DasBasti/DuetX/README.md

# DuetX
Duet electronics extension Board with up to four more stepper driver
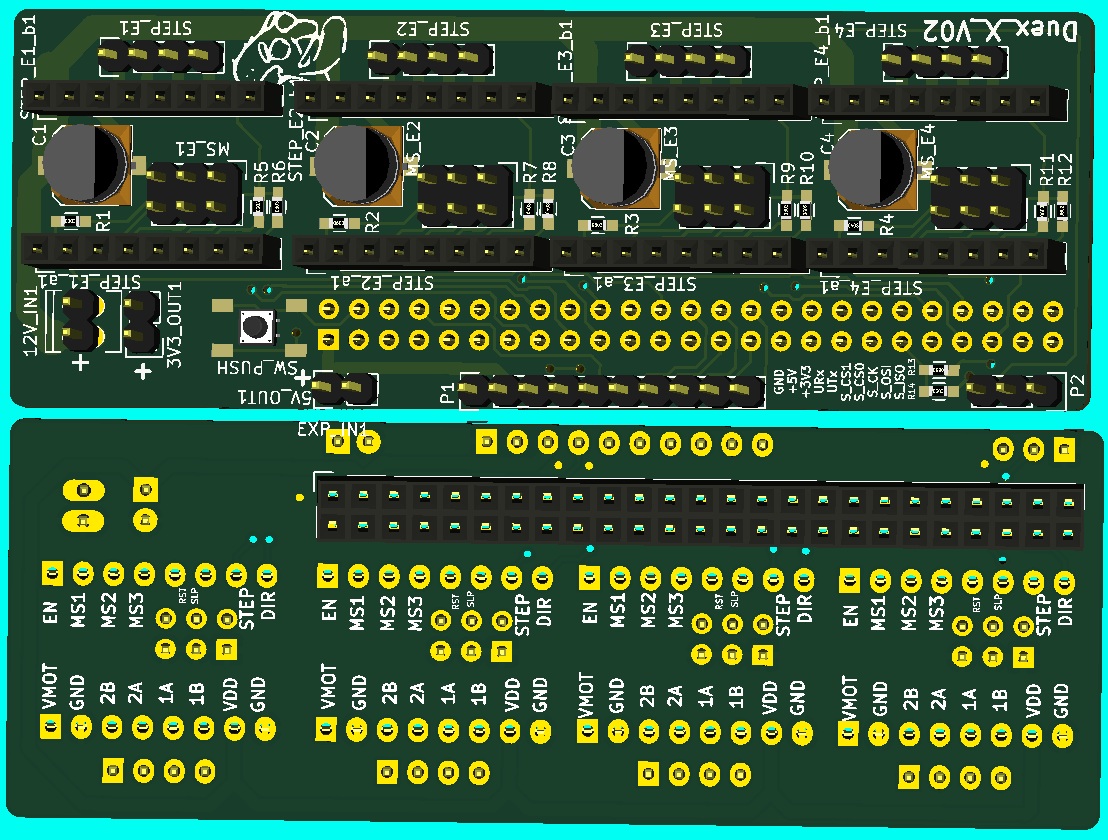
[picture p1: 3D.jpg]
3D rendering


#License
This hardware is open-source under the CERN Open Hardware License (OSH) V1.2
