DasBasti/DuetX/BOM_RS.xlsx

ref | value | footprint | RS
EXP_IN1 | CONN_02X25 | Pin_Headers:Pin_Header_Straight_2x25 | 628-8464
STEP_E1_a1 | CONN_01X08 | Pin_Headers:Pin_Header_Straight_1x08 | 827-734
STEP_E1_b1 | CONN_01X08 | Pin_Headers:Pin_Header_Straight_1x08 | 827-734
MS_E1 | CONN_02X03 | Pin_Headers:Pin_Header_Straight_2x03 | 827-7781
STEP_E1 | CONN_01X04 | Pin_Headers:Pin_Header_Straight_1x04 | 681-2988
12V_IN1 | CONN_01X02 | sirona:mkds_1,5-2 | 425-8720
5V_OUT1 | CONN_01X02 | Pin_Headers:Pin_Header_Straight_1x02 | n_best
R5 | 10K | Resistors_SMD:R_0603_HandSoldering | 678-9667
R6 | 10K | Resistors_SMD:R_0603_HandSoldering | 678-9667
C1 | CP2 | Capacitors_SMD:c_elec_6.3x5.7 | 844-0926
STEP_E2_a1 | CONN_01X08 | Pin_Headers:Pin_Header_Straight_1x08 | 827-734
STEP_E2_b1 | CONN_01X08 | Pin_Headers:Pin_Header_Straight_1x08 | 827-734
MS_E2 | CONN_02X03 | Pin_Headers:Pin_Header_Straight_2x03 | 827-7781
STEP_E2 | CONN_01X04 | Pin_Headers:Pin_Header_Straight_1x04 | 681-2988
R7 | 10K | Resistors_SMD:R_0603_HandSoldering | 678-9667
R8 | 10K | Resistors_SMD:R_0603_HandSoldering | 678-9667
C2 | CP2 | Capacitors_SMD:c_elec_6.3x5.7 | 844-0926
STEP_E3_a1 | CONN_01X08 | Pin_Headers:Pin_Header_Straight_1x08 | 827-734
STEP_E3_b1 | CONN_01X08 | Pin_Headers:Pin_Header_Straight_1x08 | 827-734
MS_E3 | CONN_02X03 | Pin_Headers:Pin_Header_Straight_2x03 | 827-7781
STEP_E3 | CONN_01X04 | Pin_Headers:Pin_Header_Straight_1x04 | 681-2988
R9 | 10K | Resistors_SMD:R_0603_HandSoldering | 678-9667
R10 | 10K | Resistors_SMD:R_0603_HandSoldering | 678-9667
C3 | CP2 | Capacitors_SMD:c_elec_6.3x5.7 | 844-0926
STEP_E4_a1 | CONN_01X08 | Pin_Headers:Pin_Header_Straight_1x08 | 827-734
STEP_E4_b1 | CONN_01X08 | Pin_Headers:Pin_Header_Straight_1x08 | 827-734
MS_E4 | CONN_02X03 | Pin_Headers:Pin_Header_Straight_2x03 | 827-7781
STEP_E4 | CONN_01X04 | Pin_Headers:Pin_Header_Straight_1x04 | 681-2988
R11 | 10K | Resistors_SMD:R_0603_HandSoldering | 678-9667
R12 | 10K | Resistors_SMD:R_0603_HandSoldering | 678-9667
C4 | CP2 | Capacitors_SMD:c_elec_6.3x5.7 | 844-0926
3V3_OUT1 | CONN_01X02 | Pin_Headers:Pin_Header_Straight_1x02 | n_best
R4 | 10K | Resistors_SMD:R_0603_HandSoldering | 678-9667
R3 | 10K | Resistors_SMD:R_0603_HandSoldering | 678-9667
R2 | 10K | Resistors_SMD:R_0603_HandSoldering | 678-9667
R1 | 10K | Resistors_SMD:R_0603_HandSoldering | 678-9667
SW1 | SW_PUSH | sirona:TACT_switch
P1 | CONN_01X10 | Pin_Headers:Pin_Header_Straight_1x10 | n_best
P2 | CONN_01X03 | Pin_Headers:Pin_Header_Straight_1x03 | n_best
R13 | 2K7 | Resistors_SMD:R_0603_HandSoldering | n_best
R14 | 1K | Resistors_SMD:R_0603_HandSoldering | n_best
R18 | 10K | Resistors_SMD:R_0603_HandSoldering | 678-9667
R17 | 10K | Resistors_SMD:R_0603_HandSoldering | 678-9667
R16 | 10K | Resistors_SMD:R_0603_HandSoldering | 678-9667
R15 | 10K | Resistors_SMD:R_0603_HandSoldering | 678-9667
 |  |  | 462.30 €
 |  |  | 15.41 €
 |  | Driver 4 Stk 5€
 |  | PCB 42€
