DasBasti/DuetX/DUETX_X.pdf

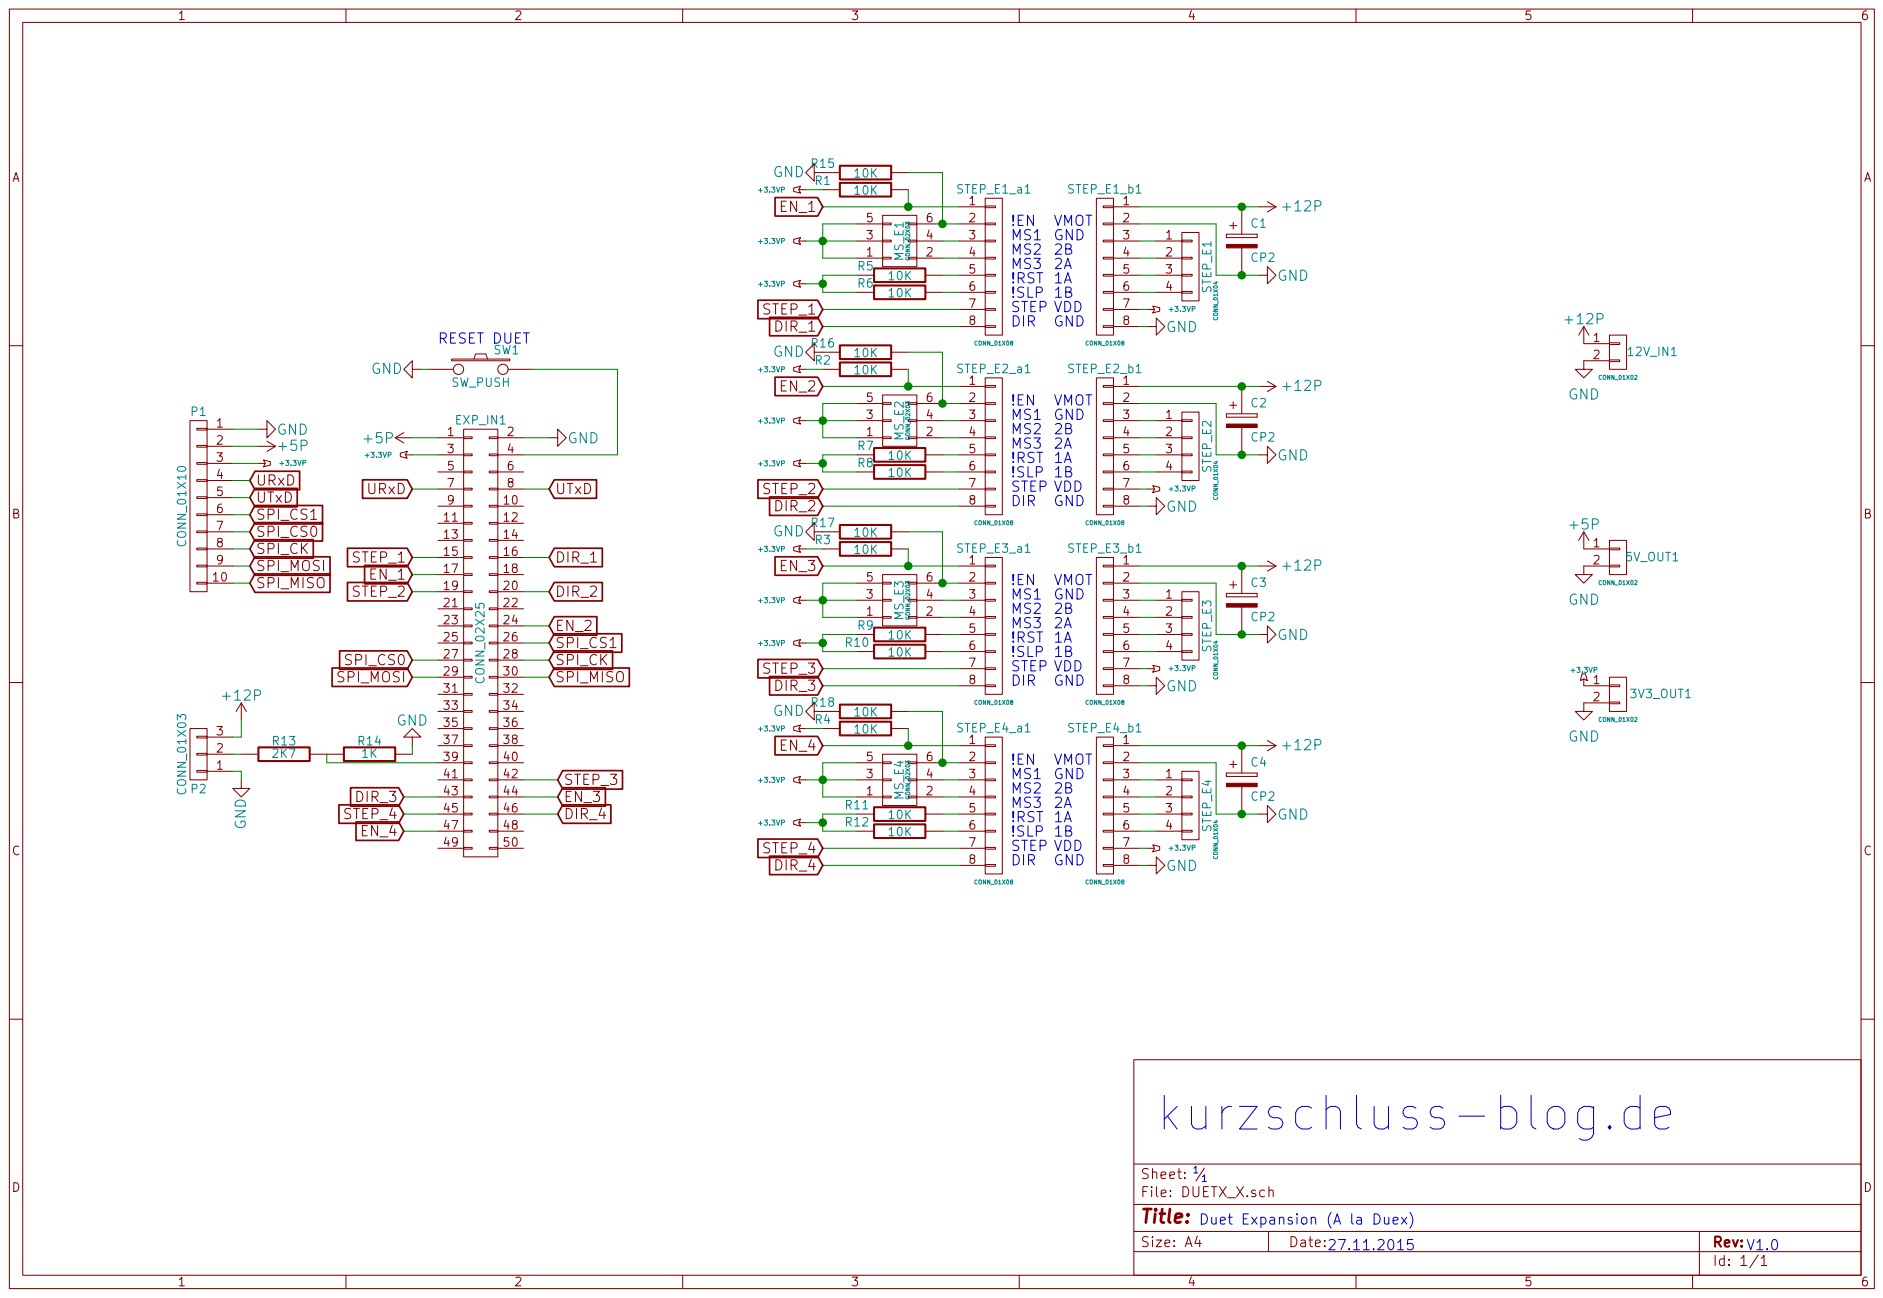
[picture p2: page 1]

27.11.2015 Duet Expansion (A la Duex) 1
