DasBasti/DuetX/DUETX_X.kicad_pcb

## KiCad design DUETX_X.kicad_pcb (2016-03-08)

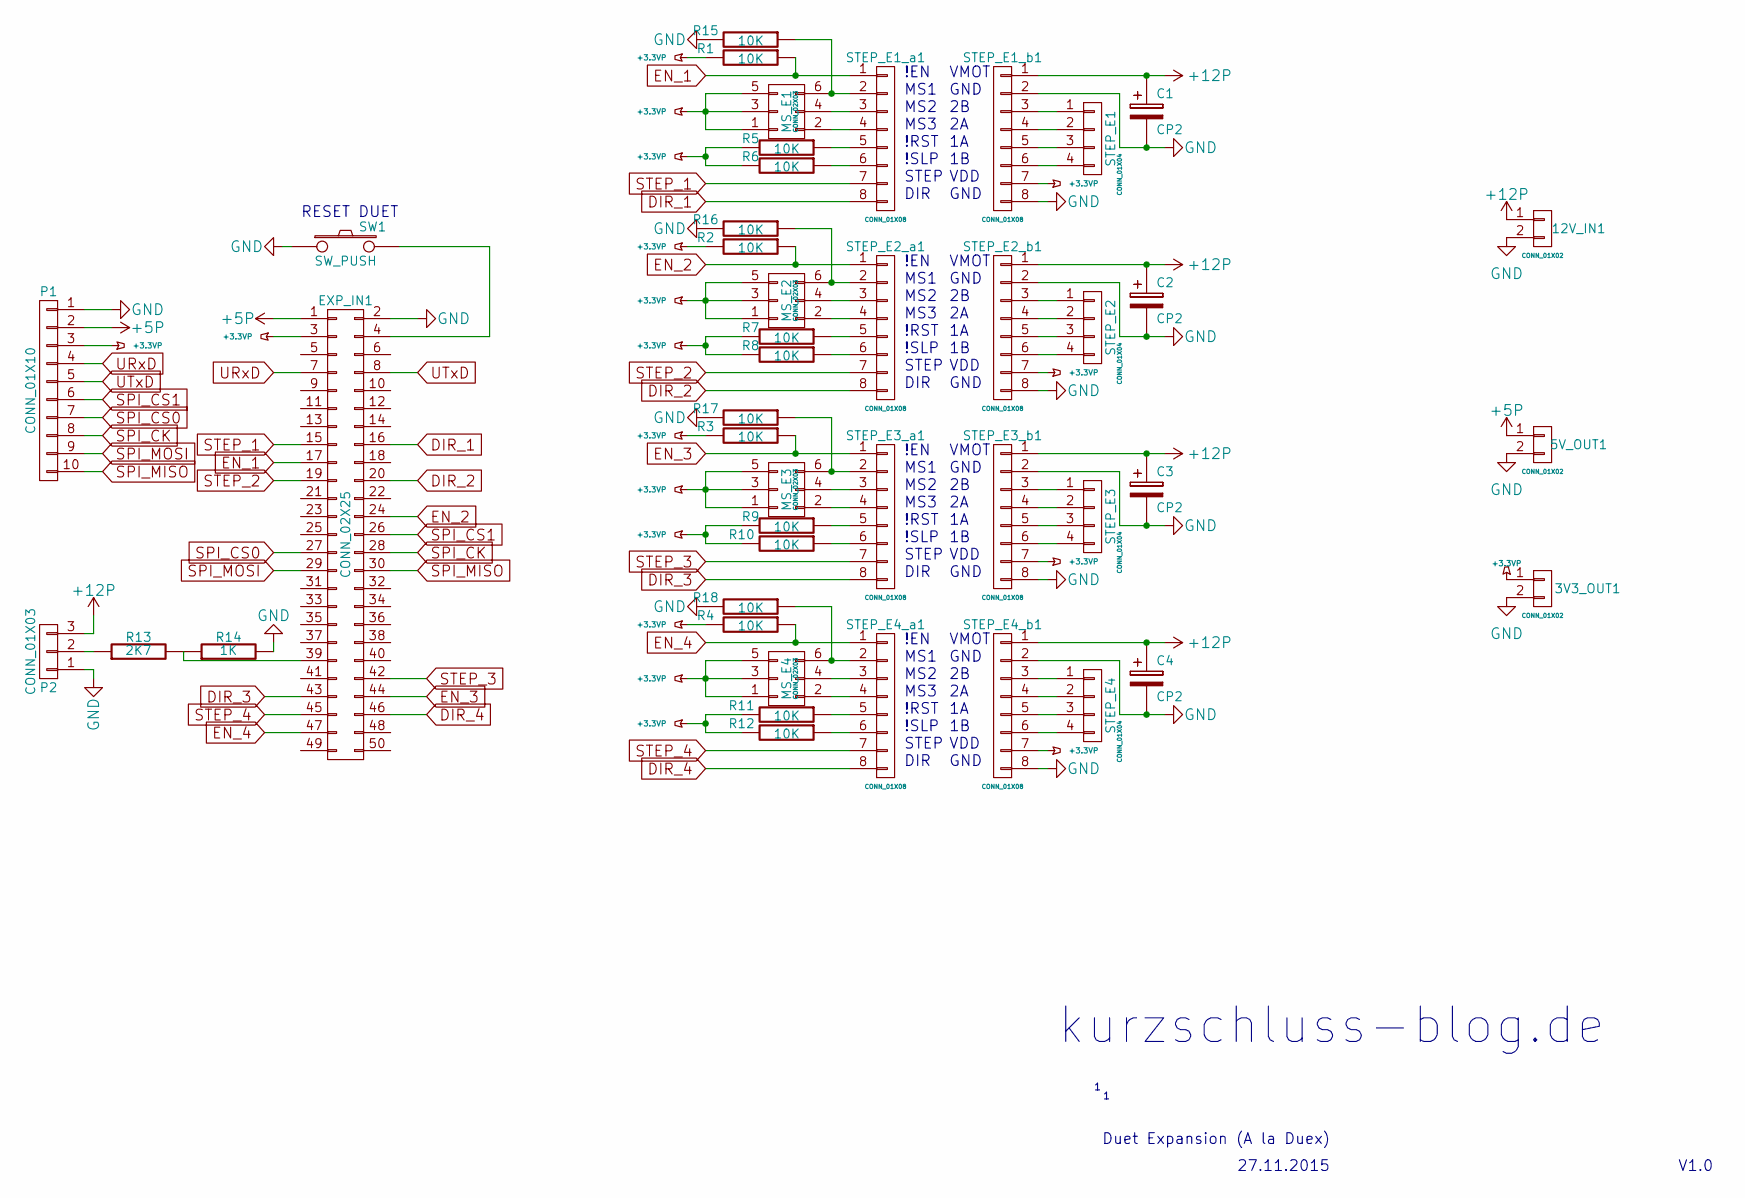
[picture p3: schematic DUETX_X.sch]

Parts:
3V3_OUT1, 5V_OUT1: CONN_01X02; Pin_Header_Straight_1x02
12V_IN1: CONN_01X02; mkds_1,5-2
C1, C2, C3, C4: CP2; c_elec_6.3x5.7
EXP_IN1: CONN_02X25; Pin_Header_Straight_2x25
MS_E1, MS_E2, MS_E3, MS_E4: CONN_02X03; Pin_Header_Straight_2x03
P1: CONN_01X10; Pin_Header_Straight_1x10
P2: CONN_01X03; Pin_Header_Straight_1x03
R1, R2, R3, R4, R5, R6, R7, R8, R9, R10, R11, R12, R15, R16, R17, R18: 10K; R_0603_HandSoldering
R13: 2K7; R_0603_HandSoldering
R14: 1K; R_0603_HandSoldering
STEP_E1, STEP_E2, STEP_E3, STEP_E4: CONN_01X04; Pin_Header_Straight_1x04
STEP_E1_a1, STEP_E1_b1, STEP_E2_a1, STEP_E2_b1, STEP_E3_a1, STEP_E3_b1, STEP_E4_a1, STEP_E4_b1: CONN_01X08; Pin_Header_Straight_1x08
SW1: SW_PUSH; TACT_switch

Connections:
+3.3VP: 3V3_OUT1.1, EXP_IN1.3, MS_E1.1, MS_E1.3, MS_E1.5, MS_E2.1, MS_E2.3, MS_E2.5, MS_E3.1, MS_E3.3, MS_E3.5, MS_E4.1, MS_E4.3, MS_E4.5, P1.3, R1.2, R2.2, R3.2, R4.2, R5.2, R6.2, R7.2, R8.2, R9.2, R10.2, R11.2, R12.2, STEP_E1_b1.7, STEP_E2_b1.7, STEP_E3_b1.7, STEP_E4_b1.7
+5P: 5V_OUT1.1, EXP_IN1.1, P1.2
+12P: 12V_IN1.1, C1.1, C2.1, C3.1, C4.1, P2.3, STEP_E1_b1.1, STEP_E2_b1.1, STEP_E3_b1.1, STEP_E4_b1.1
DIR_1: EXP_IN1.16, STEP_E1_a1.8
DIR_2: EXP_IN1.20, STEP_E2_a1.8
DIR_3: EXP_IN1.43, STEP_E3_a1.8
DIR_4: EXP_IN1.46, STEP_E4_a1.8
EN_1: EXP_IN1.17, R1.1, STEP_E1_a1.1
EN_2: EXP_IN1.24, R2.1, STEP_E2_a1.1
EN_3: EXP_IN1.44, R3.1, STEP_E3_a1.1
EN_4: EXP_IN1.47, R4.1, STEP_E4_a1.1
GND: 3V3_OUT1.2, 5V_OUT1.2, 12V_IN1.2, C1.2, C2.2, C3.2, C4.2, EXP_IN1.2, P1.1, P2.1, R14.2, R15.2, R16.2, R17.2, R18.2, STEP_E1_b1.2, STEP_E1_b1.8, STEP_E2_b1.2, STEP_E2_b1.8, STEP_E3_b1.2, STEP_E3_b1.8, STEP_E4_b1.2, STEP_E4_b1.8, SW1.1; also elsewhere on the board
unnamed 12: EXP_IN1.4, SW1.2; also elsewhere on the board
unnamed: EXP_IN1.39, R13.2, R14.1
unnamed: MS_E1.2, STEP_E1_a1.4
unnamed: MS_E1.4, STEP_E1_a1.3
unnamed: MS_E1.6, R15.1, STEP_E1_a1.2
unnamed: MS_E2.2, STEP_E2_a1.4
unnamed: MS_E2.4, STEP_E2_a1.3
unnamed: MS_E2.6, R16.1, STEP_E2_a1.2
unnamed: MS_E3.2, STEP_E3_a1.4
unnamed: MS_E3.4, STEP_E3_a1.3
unnamed: MS_E3.6, R17.1, STEP_E3_a1.2
unnamed: MS_E4.2, STEP_E4_a1.4
unnamed: MS_E4.4, STEP_E4_a1.3
unnamed: MS_E4.6, R18.1, STEP_E4_a1.2
unnamed: P2.2, R13.1
unnamed: R5.1, STEP_E1_a1.5
unnamed: R6.1, STEP_E1_a1.6
unnamed: R7.1, STEP_E2_a1.5
unnamed: R8.1, STEP_E2_a1.6
unnamed: R9.1, STEP_E3_a1.5
unnamed: R10.1, STEP_E3_a1.6
unnamed: R11.1, STEP_E4_a1.5
unnamed: R12.1, STEP_E4_a1.6
unnamed: STEP_E1.1, STEP_E1_b1.3
unnamed: STEP_E1.2, STEP_E1_b1.4
unnamed: STEP_E1.3, STEP_E1_b1.5
unnamed: STEP_E1.4, STEP_E1_b1.6
unnamed: STEP_E2.1, STEP_E2_b1.3
unnamed: STEP_E2.2, STEP_E2_b1.4
unnamed: STEP_E2.3, STEP_E2_b1.5
unnamed: STEP_E2.4, STEP_E2_b1.6
unnamed: STEP_E3.1, STEP_E3_b1.3
unnamed: STEP_E3.2, STEP_E3_b1.4
unnamed: STEP_E3.3, STEP_E3_b1.5
unnamed: STEP_E3.4, STEP_E3_b1.6
unnamed: STEP_E4.1, STEP_E4_b1.3
unnamed: STEP_E4.2, STEP_E4_b1.4
unnamed: STEP_E4.3, STEP_E4_b1.5
unnamed: STEP_E4.4, STEP_E4_b1.6
SPI_CK: EXP_IN1.28, P1.8
SPI_CS0: EXP_IN1.27, P1.7
SPI_CS1: EXP_IN1.26, P1.6
SPI_MISO: EXP_IN1.30, P1.10
SPI_MOSI: EXP_IN1.29, P1.9
STEP_1: EXP_IN1.15, STEP_E1_a1.7
STEP_2: EXP_IN1.19, STEP_E2_a1.7
STEP_3: EXP_IN1.42, STEP_E3_a1.7
STEP_4: EXP_IN1.45, STEP_E4_a1.7
URxD: EXP_IN1.7, P1.4
UTxD: EXP_IN1.8, P1.5

Notes on the sheet:
VMOT GND 2B 2A 1A 1B VDD GND
!EN MS1 MS2 MS3 !RST !SLP STEP DIR
RESET DUET
27.11.2015
Duet Expansion (A la Duex)
V1.0
kurzschluss-blog.de

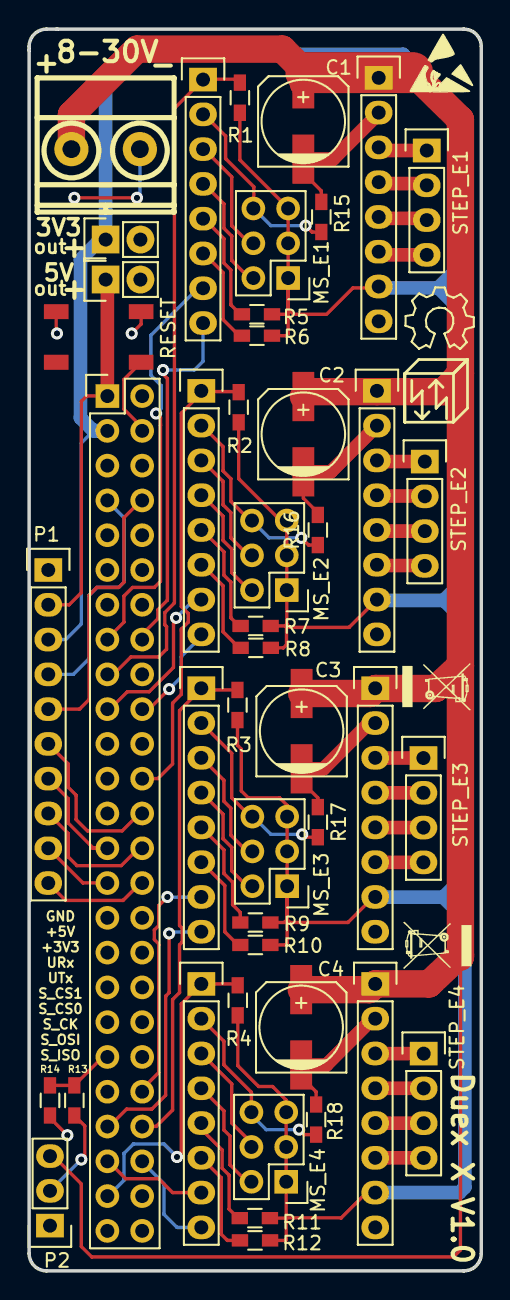
[picture p4: board DUETX_X.kicad_pcb from above]

Board: 2 copper layers, 33.0 x 90.7 mm, 45 parts (0 on the bottom side), 62 nets.

Other parts of the board:
RESET: SW_PUSH; TACT_switch

Their connections:
GND: RESET.1; also elsewhere on the board
unnamed 12: RESET.2; also elsewhere on the board
