DasBasti/DuetX/Build.instructions.pdf

Building manual for an Ormerod stepper extension board.

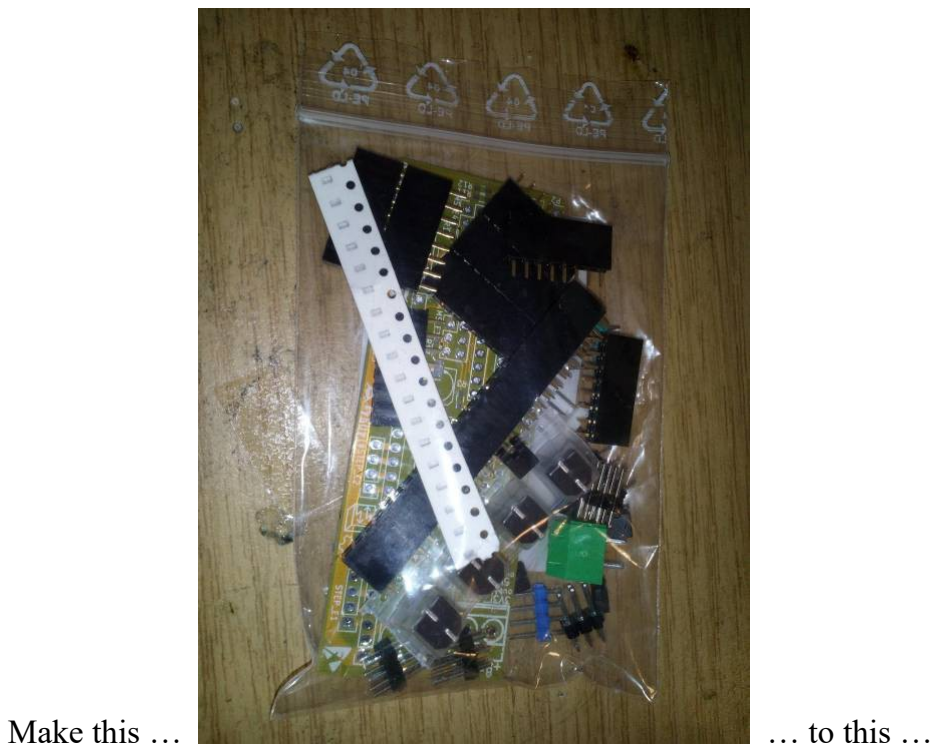
[picture p5: figure]
Make this …; … to this …
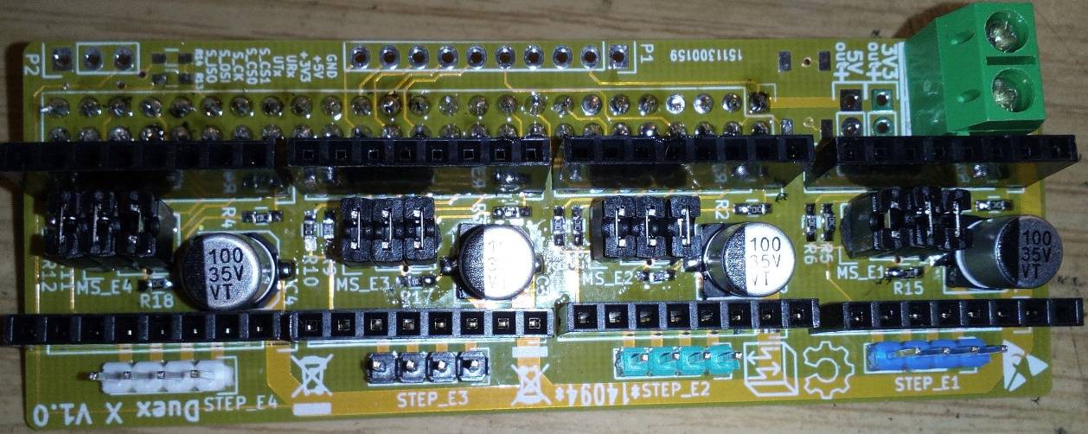
[picture p6: figure]

… in about 45 minutes.

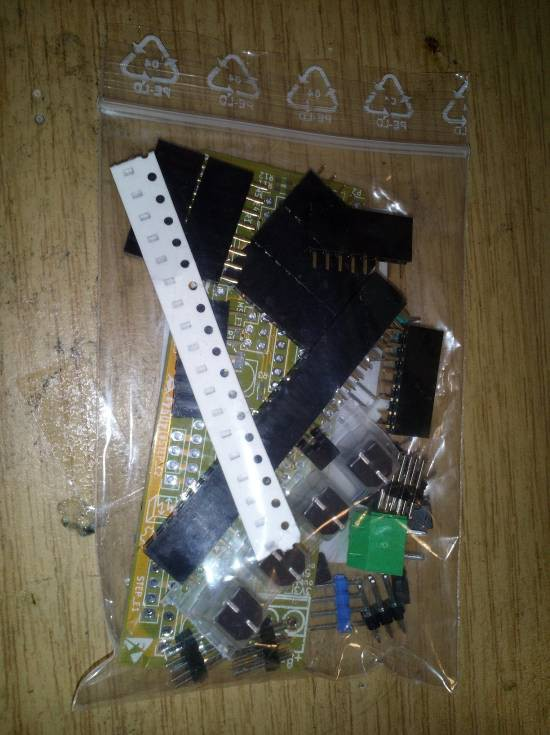
[picture p7: figure]
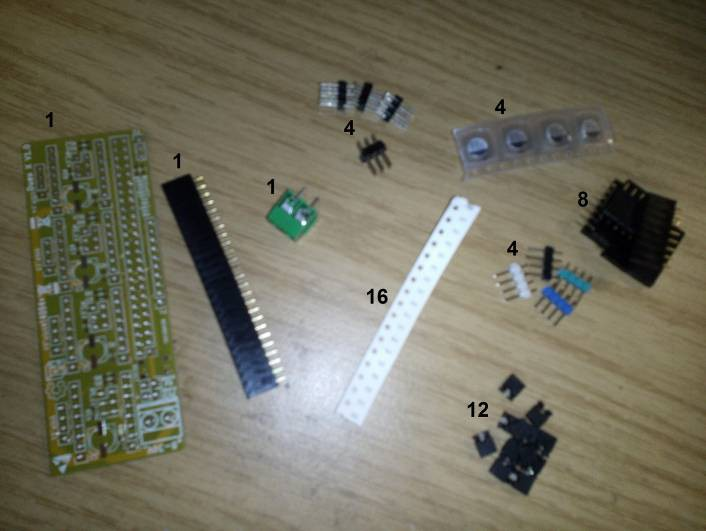
[picture p8: figure]

Partlist:

1x PCB
1x 2x25 pinheader
1x 1x2 power conector
4x 2x3 pinheader
16x 0603 10K resistors
4x 100µF 35V smd elko
4x 1x4 pinheader
12x jumper
8x 2x8 pinheader

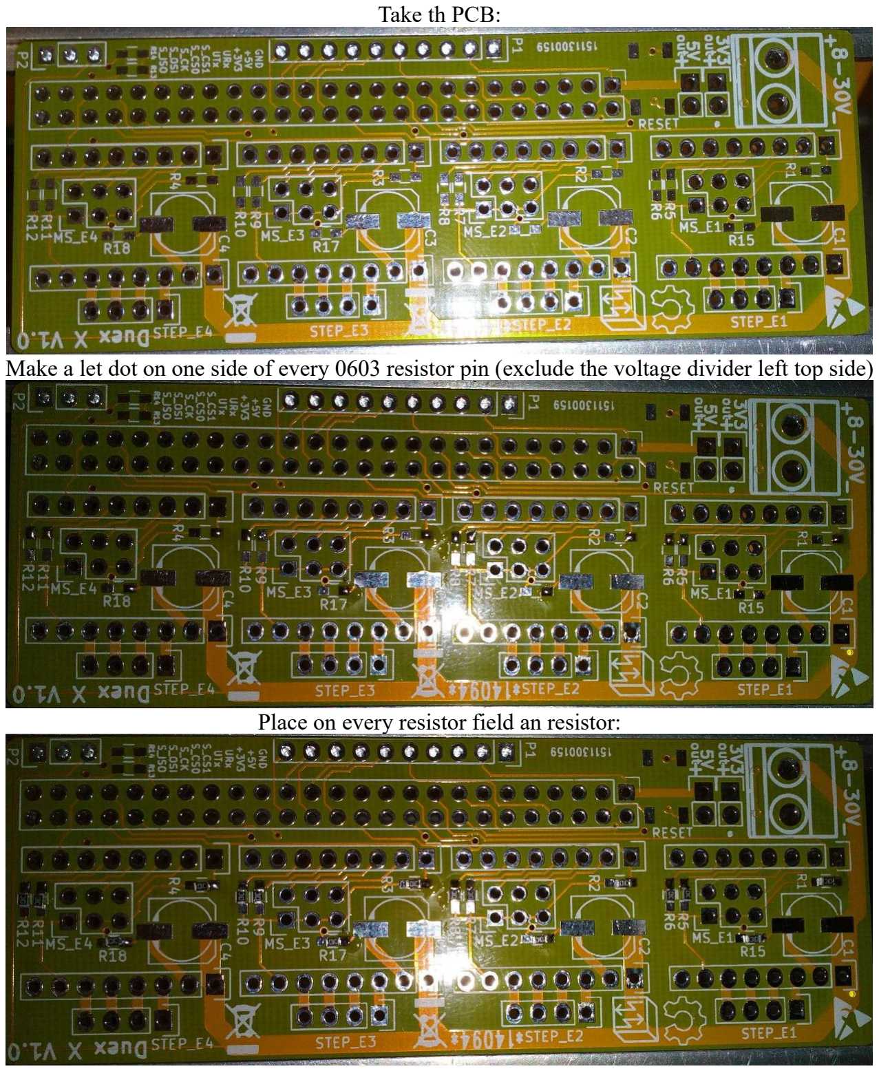
[picture p9: page 3]

Take th PCB:

Make a let dot on one side of every 0603 resistor pin (exclude the voltage divider left top side)

Place on every resistor field an resistor:

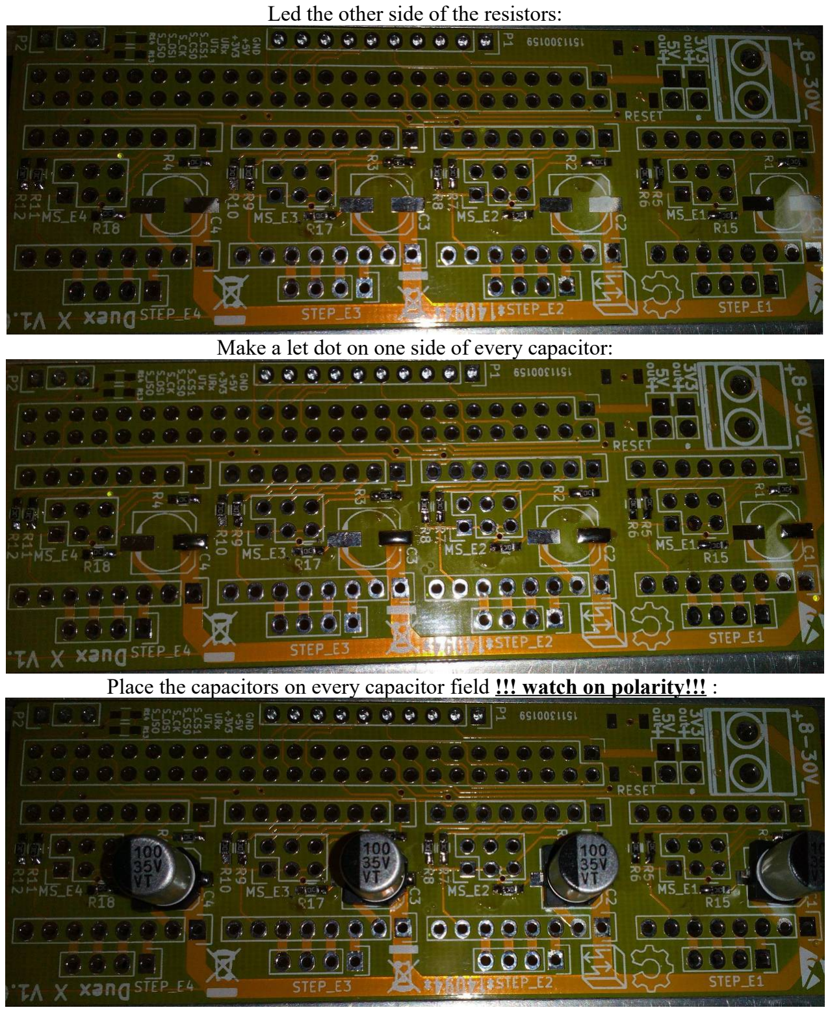
[picture p10: page 4]

Led the other side of the resistors:

Make a let dot on one side of every capacitor:

Place the capacitors on every capacitor field !!! watch on polarity!!! :

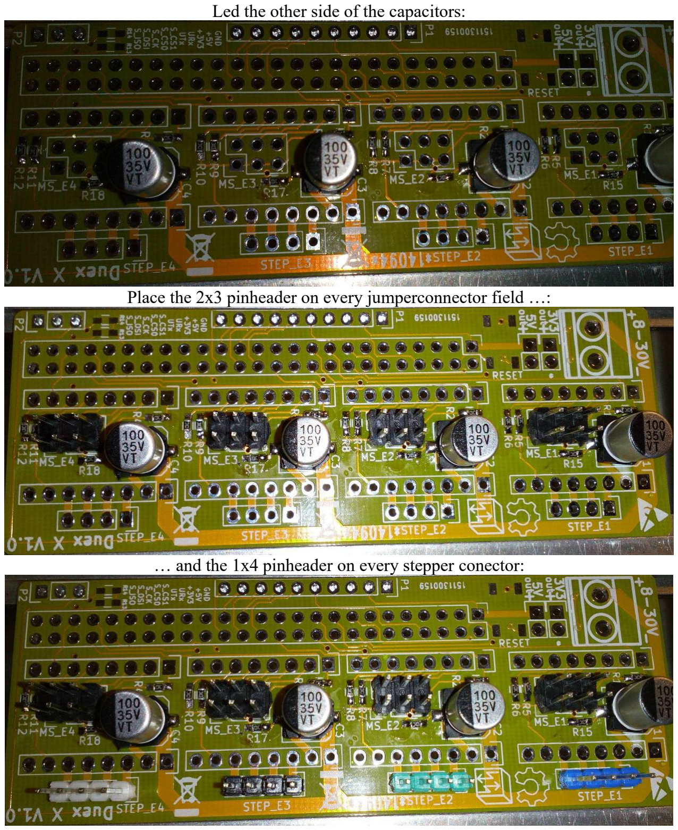
[picture p11: page 5]

Led the other side of the capacitors:

Place the 2x3 pinheader on every jumperconnector field …:

… and the 1x4 pinheader on every stepper conector:

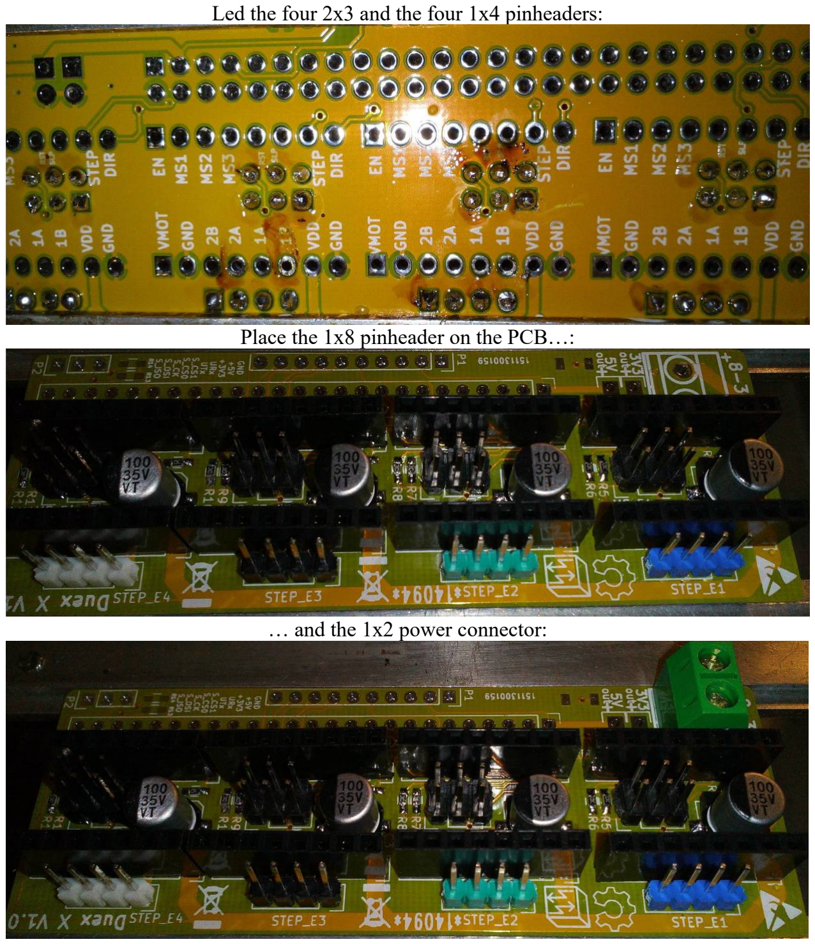
[picture p12: page 6]

Led the four 2x3 and the four 1x4 pinheaders:

Place the 1x8 pinheader on the PCB…:

… and the 1x2 power connector:

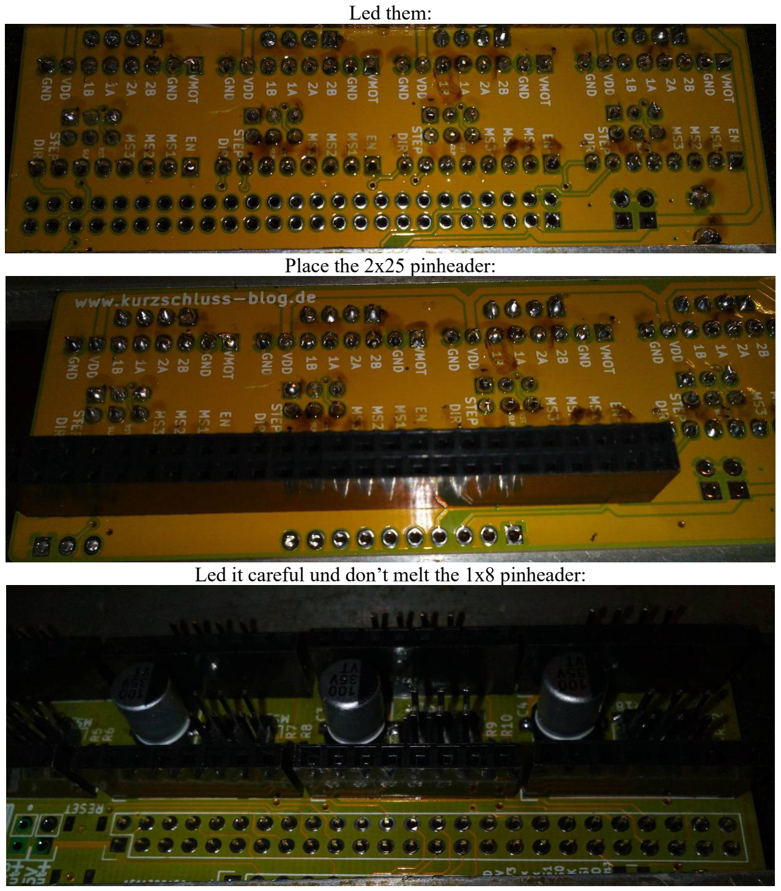
[picture p13: page 7]

Led them:

Place the 2x25 pinheader:

Led it careful und don’t melt the 1x8 pinheader:

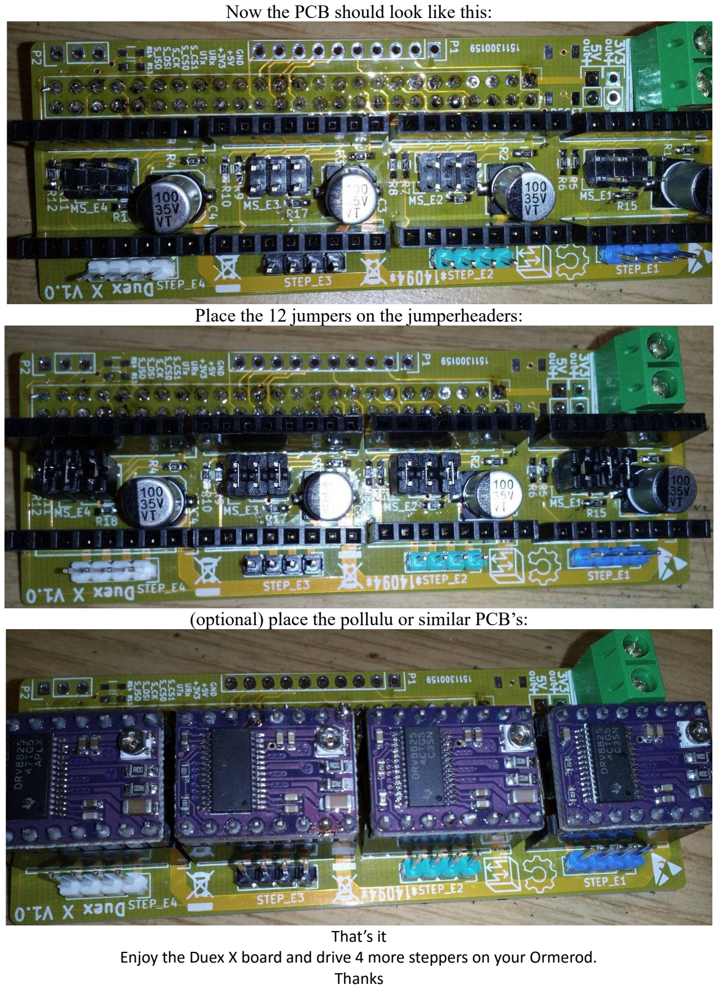
[picture p14: page 8]

Now the PCB should look like this:

Place the 12 jumpers on the jumperheaders:

(optional) place the pollulu or similar PCB’s:

That’s it
Enjoy the Duex X board and drive 4 more steppers on your Ormerod. Thanks
