DasBasti/DuetX/(commit log)

2016-03-07 Added files via upload
    inital commit of schematic, BOM, 3D rendering and building instructions
    [BOM_RS.xlsx]
2016-03-08 Gerber Files for PCB manufacturing
    [DUETX_X.gbl, DUETX_X.gbo, DUETX_X.gbs, DUETX_X.gtl, DUETX_X.gto, DUETX_X.gts]
2016-03-08 Schematics and KiCad project
    [DUETX_X.kicad_pcb, DUETX_X.sch]
